xkuceram/VRS_T_krizovatka/Core/Inc/main.h

#define MCO_Pin GPIO_PIN_0
#define MCO_GPIO_Port GPIOF
#define LED_A_RED_Pin GPIO_PIN_0
#define LED_A_RED_GPIO_Port GPIOA
#define LED_A_GREEN_Pin GPIO_PIN_1
#define LED_A_GREEN_GPIO_Port GPIOA
#define LED_BR_RED_Pin GPIO_PIN_3
#define LED_BR_RED_GPIO_Port GPIOA
#define LED_BR_GREEN_Pin GPIO_PIN_4
#define LED_BR_GREEN_GPIO_Port GPIOA
#define LED_BD_RED_Pin GPIO_PIN_7
#define LED_BD_RED_GPIO_Port GPIOA
#define LED_C_RED_Pin GPIO_PIN_0
#define LED_C_RED_GPIO_Port GPIOB
#define LED_C_GREEN_Pin GPIO_PIN_1
#define LED_C_GREEN_GPIO_Port GPIOB
#define LED_BD_GREEN_Pin GPIO_PIN_8
#define LED_BD_GREEN_GPIO_Port GPIOA
#define P_BTN_Pin GPIO_PIN_10
#define P_BTN_GPIO_Port GPIOA
#define LED_AS_GREEN_Pin GPIO_PIN_11
#define LED_AS_GREEN_GPIO_Port GPIOA
#define CAR_C_Pin GPIO_PIN_12
#define CAR_C_GPIO_Port GPIOA
#define SWDIO_Pin GPIO_PIN_13
#define SWDIO_GPIO_Port GPIOA
#define SWCLK_Pin GPIO_PIN_14
#define SWCLK_GPIO_Port GPIOA
#define LED_CS_GREEN_Pin GPIO_PIN_3
#define LED_CS_GREEN_GPIO_Port GPIOB
#define LED_P_GREEN_Pin GPIO_PIN_4
#define LED_P_GREEN_GPIO_Port GPIOB
#define LED_P_RED_Pin GPIO_PIN_5
#define LED_P_RED_GPIO_Port GPIOB
